thatch/makerspace-auth/hardware/epilog-mini-bracket-1/README.md

## One-box version

Very spacious, plenty of room to add an internal speaker.

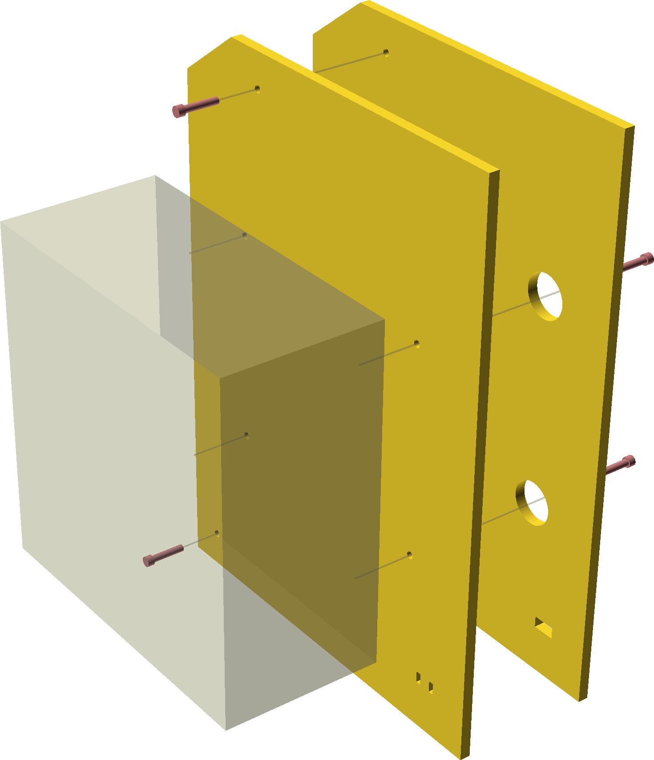
[picture p1: hardware/epilog-mini-bracket-1/one_box_mount_demo.png]


| Item | Qty |
| --- | --- |
| M4x14 | 8 |
| M4 nut | 8 |
| M4 (fender) washer | 8 |
| #8-32 x 7/8" or 1" | 2 |

## Two-box version

This version allows you to put a Power Switch Tail in the rear box, while the
front one houses the Pi, buttons, and badge reader.

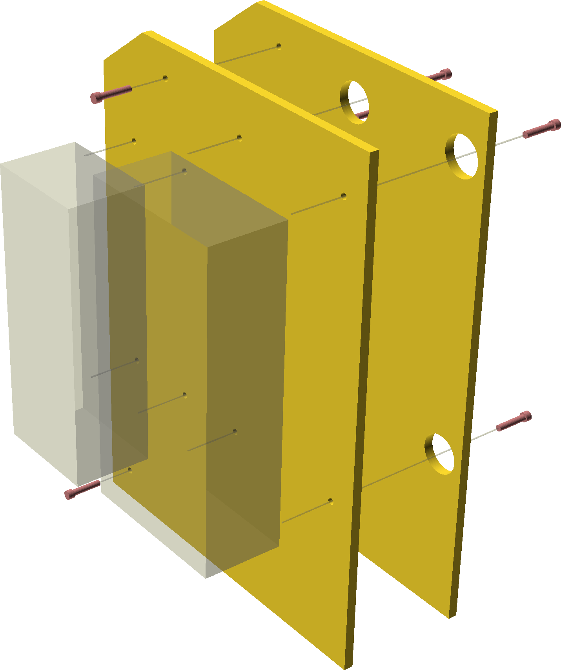
[picture p2: hardware/epilog-mini-bracket-1/two_box_mount_demo.png]


| Item | Qty |
| --- | --- |
| M4x14 | 4 |
| M4 nut | 4 |
| M4 (fender) washer | 4 |
| #8-32 x 7/8" or 1" | 2 |
