thatch/makerspace-auth/(list of files, cad)

Other CAD files:
hardware/epilog-mini-bracket-1/two_box_mount.scad
hardware/epilog-mini-bracket-1/one_box_mount_hole_template.scad
hardware/epilog-mini-bracket-1/one_box_mount_inner.scad
hardware/epilog-mini-bracket-1/one_box_mount_demo.scad
hardware/epilog-mini-bracket-1/one_box_mount_outer.scad
hardware/epilog-mini-bracket-1/two_box_mount_demo.scad
hardware/epilog-mini-bracket-1/two_box_mount_inner.scad
hardware/epilog-mini-bracket-1/two_box_mount_lib.scad
hardware/epilog-mini-bracket-1/two_box_mount_outer.scad
