thatch/makerspace-auth/hardware/pi-hat-1/ms_auth_breakout.brd

## EAGLE design hardware/pi-hat-1/ms_auth_breakout.brd (2017-05-28)

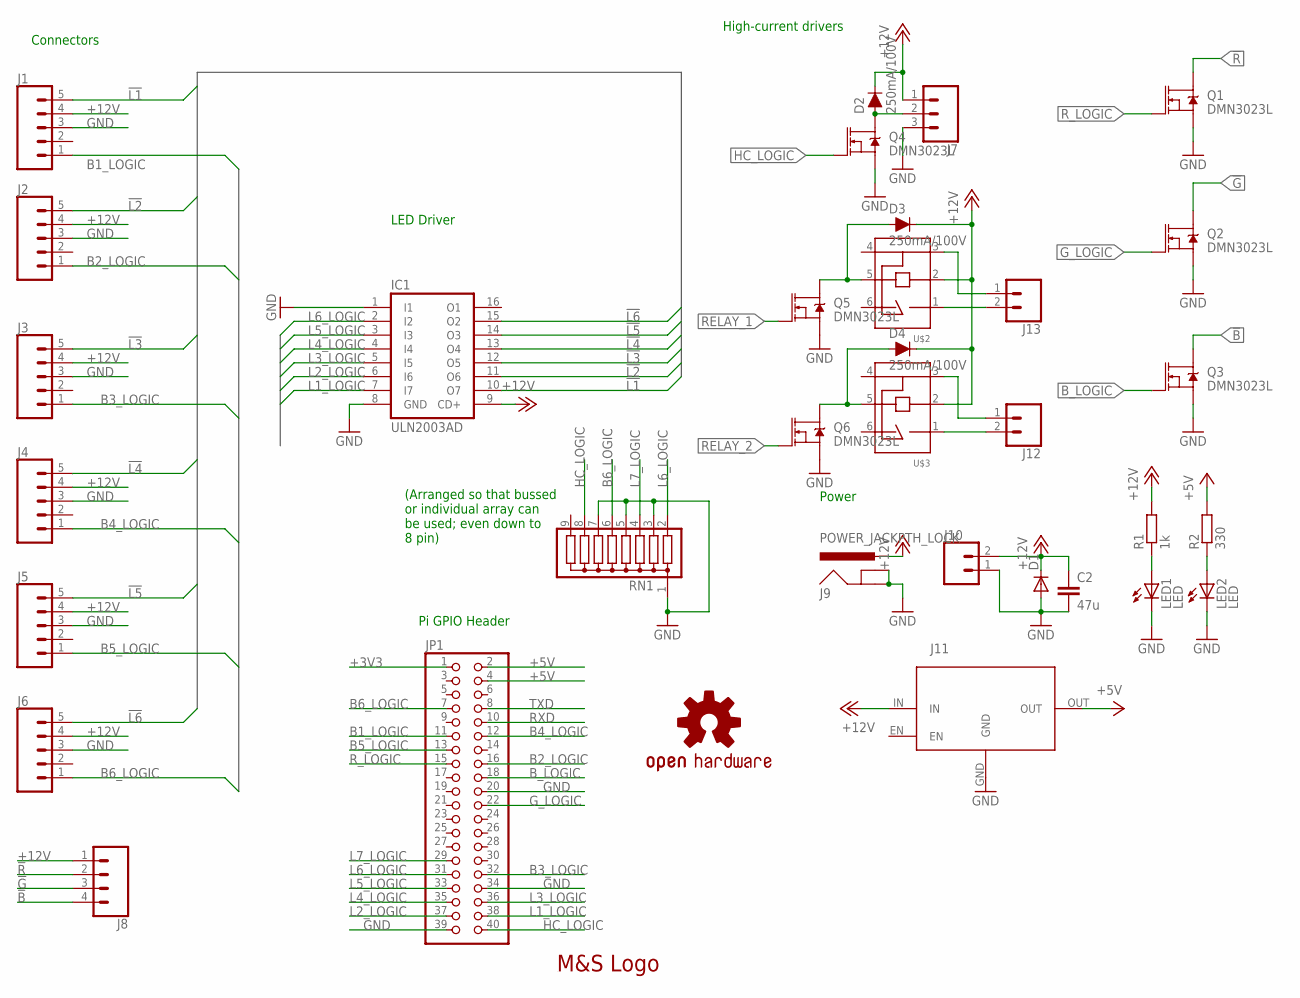
[picture p3: schematic ms_auth_breakout.sch]

Parts:
C2: 47u; C1206
D1: DIODE-DO-214AC; DO-214AC
D2, D3, D4: 250mA/100V; SOD-323
IC1: ULN2003AD; SO16
J1, J2, J3, J4, J5, J6: CONN_05POLAR_LOCK; MOLEX-1X5_LOCK
J7: CONN_03POLAR_LOCK; MOLEX-1X3_LOCK
J8: CONN_04POLAR_LOCK; MOLEX-1X4_LOCK
J9: POWER_JACKPTH_LOCK; POWER_JACK_PTH_LOCK
J10, J12, J13: CONN_02POLAR_LOCK; MOLEX-1X2_LOCK
J11: BUCK_MODULEHORIZONTAL; BUCK_HORIZONTAL
JP1: PINHD-2X20; 2X20
LED1, LED2: LED; CHIPLED_0805
LOGO1: OSHW-LOGOM; OSHW-LOGO-M
Q1, Q2, Q3, Q4, Q5, Q6: DMN3023L; SOT23-3
R1: 1k; R0603
R2: 330; R0603
RN1: G08R; SIL9
U$1: MS_LOGO; MS_LOGO_VECTOR
U$2, U$3: HFD23_SPDT; HFD23

Connections:
!B: J8.4, Q3.3 (D)
!G: J8.3, Q2.3 (D)
!L1: IC1.10 (O7), J1.5
!L2: IC1.11 (O6), J2.5
!L3: IC1.12 (O5), J3.5
!L4: IC1.13 (O4), J4.5
!L5: IC1.14 (O3), J5.5
!L6: IC1.15 (O2), J6.5
!R: J8.2, Q1.3 (D)
+3V3: JP1.1
+5V: J11.OUT, JP1.2, JP1.4, R2.2
+12V: C2.1, D1.C, D2.C, D3.C, D4.C, IC1.9 (CD+), J1.4, J2.4, J3.4, J4.4, J5.4, J6.4, J7.1, J8.1, J9.PWR, J10.2, J11.IN, R1.2, U$2.2, U$3.2
B1_LOGIC: J1.1, JP1.11
B2_LOGIC: J2.1, JP1.16
B3_LOGIC: J3.1, JP1.32
B4_LOGIC: J4.1, JP1.12
B5_LOGIC: J5.1, JP1.13
B6_LOGIC: J6.1, JP1.7, RN1.6
B_LOGIC: JP1.18, Q3.1 (G)
GND: C2.2, D1.A, IC1.1 (I1), IC1.8 (GND), J1.3, J2.3, J3.3, J4.3, J5.3, J6.3, J7.3, J9.GND, J9.GNDBREAK, J10.1, J11.GND, JP1.20, JP1.34, JP1.39, LED1.C, LED2.C, Q1.2 (S), Q2.2 (S), Q3.2 (S), Q4.2 (S), Q5.2 (S), Q6.2 (S), RN1.1, RN1.3, RN1.5, RN1.7
G_LOGIC: JP1.22, Q2.1 (G)
HC_LOGIC: JP1.40, Q4.1 (G), RN1.8
L1_LOGIC: IC1.7 (I7), JP1.38
L2_LOGIC: IC1.6 (I6), JP1.37
L3_LOGIC: IC1.5 (I5), JP1.36
L4_LOGIC: IC1.4 (I4), JP1.35
L5_LOGIC: IC1.3 (I3), JP1.33
L6_LOGIC: IC1.2 (I2), JP1.31, RN1.2
L7_LOGIC: JP1.29, RN1.4
unnamed: D4.A, Q6.3 (D), U$3.5
unnamed: D2.A, J7.2, Q4.3 (D)
unnamed: D3.A, Q5.3 (D), U$2.5
unnamed: LED2.A, R2.1
unnamed: J13.2, U$2.1
unnamed: J13.1, U$2.3
unnamed: LED1.A, R1.1
unnamed: J12.1, U$3.3
unnamed: J12.2, U$3.1
RELAY_1: Q5.1 (G)
RELAY_2: Q6.1 (G)
RXD: JP1.10
R_LOGIC: JP1.15, Q1.1 (G)
TXD: JP1.8

Notes on the sheet:
Pi GPIO Header
LED Driver
Connectors
Power
High-current drivers
(Arranged so that bussed or individual array can be used; even down to 8 pin)

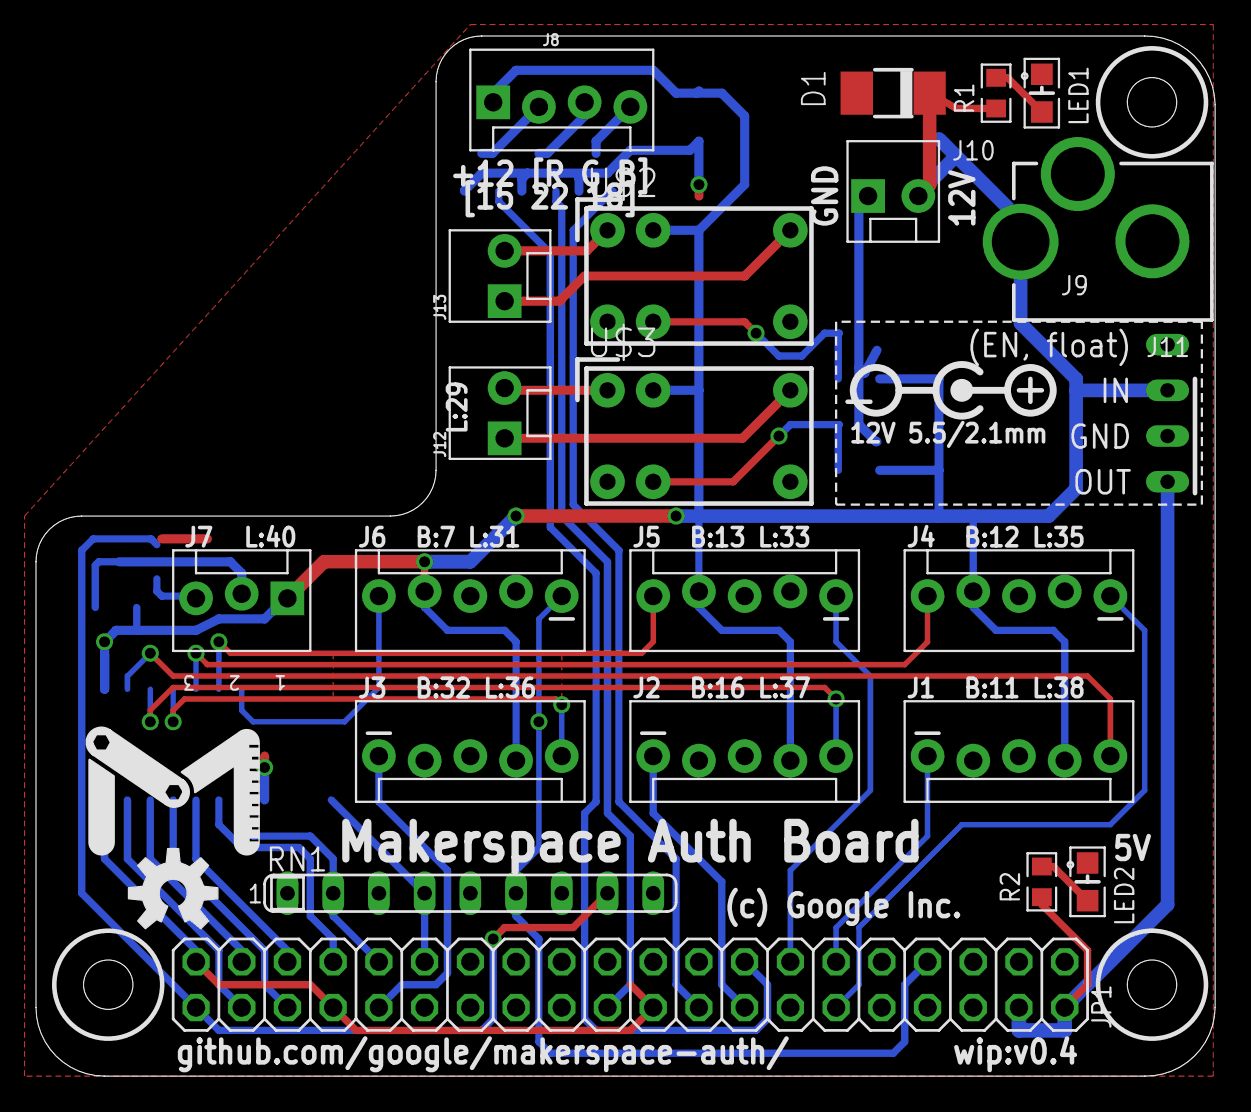
[picture p4: board ms_auth_breakout.brd from above]

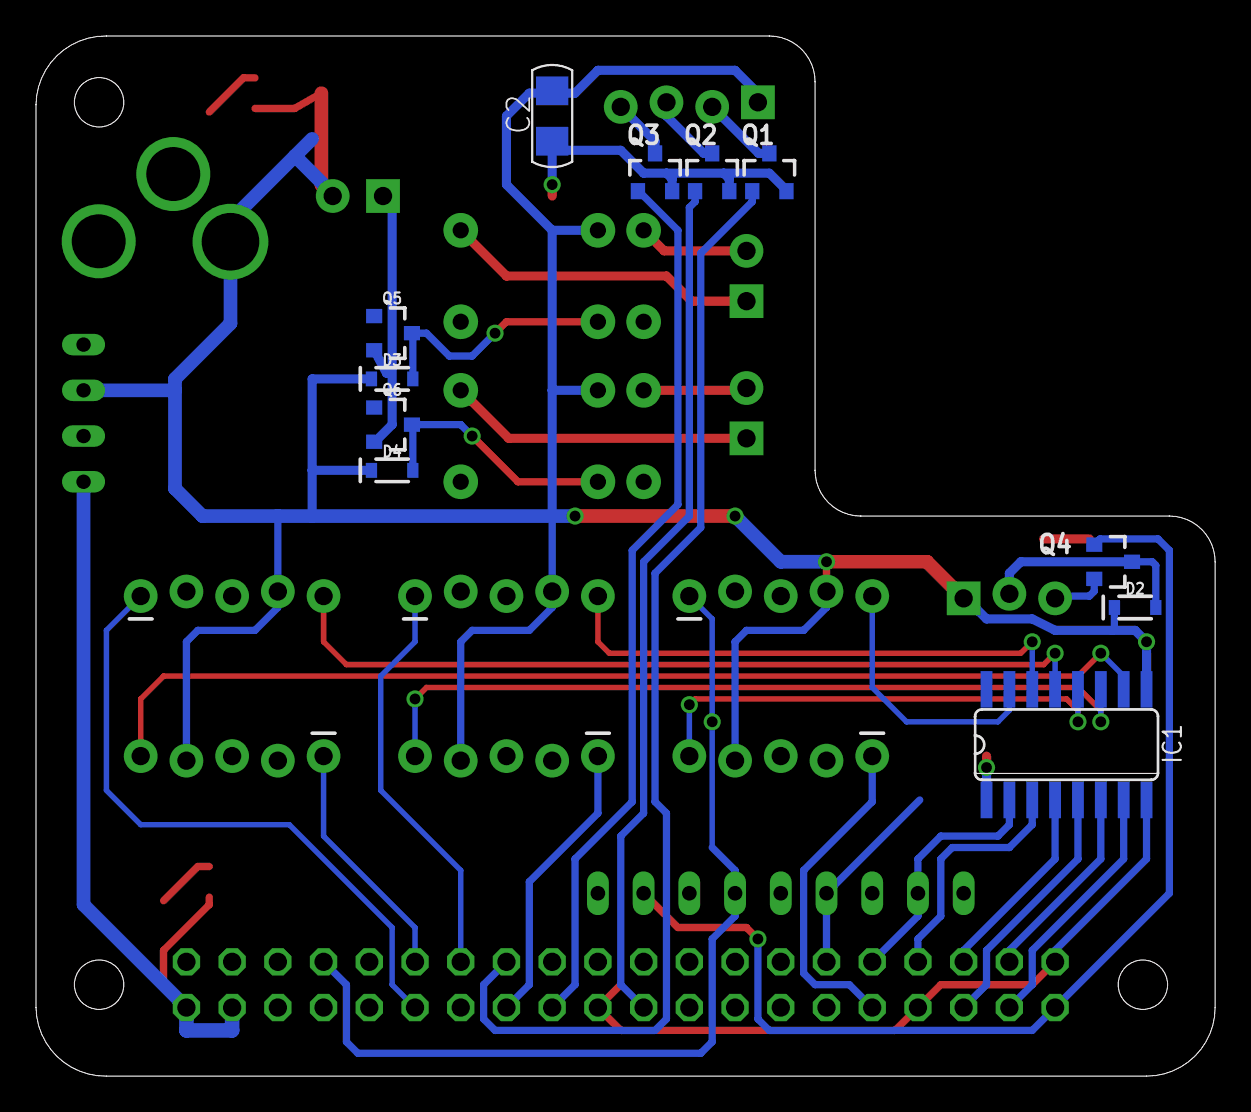
[picture p5: board ms_auth_breakout.brd from below]

Board: 2 copper layers, 65.5 x 57.8 mm, 35 parts (11 on the bottom side), 38 nets.
