thatch/makerspace-auth/(commit log)

2017-05-28 Fix buck-module ENABLE pin location
2017-05-28 Add libs for relay and opto
2017-05-28 Rework board to add two relays.
    Also remove buzzer, change LED connector, and standardize on smaller
    freewheel diodes. Not quire ready for 0.4 cut; needs airwires routed
    for relays with solder jumpers.
    [ms_auth_breakout.brd, ms_auth_breakout.sch]
2018-02-06 Add preliminary two-box mounting plate for Epilog Mini right side
    [two_box_mount.scad]
2018-02-06 Add exploded view and render of two box
    [two_box_mount.scad]
2018-02-08 Add one-box mount; update makefile
    [one_box_mount_demo.scad, one_box_mount_inner.scad, one_box_mount_lib.scad, one_box_mount_outer.scad, two_box_mount_demo.scad, two_box_mount_inner.scad, two_box_mount_lib.scad, two_box_mount_outer.scad]
2018-02-09 Explicitly set units to mm for easier printing. Add template.
    [one_box_mount_hole_template.scad, one_box_mount_lib.scad]
2018-02-09 Add ziptie holes to one_box_mount
    [one_box_mount_lib.scad]
2018-02-12 Change one box hole pattern
    [one_box_mount_lib.scad]
2019-06-06 Add tests and switch to queue for badgereader_wiegand.
    The queue actually makes the testing logic way easier.
